rahulahooper/watering-system/pcb.JPG

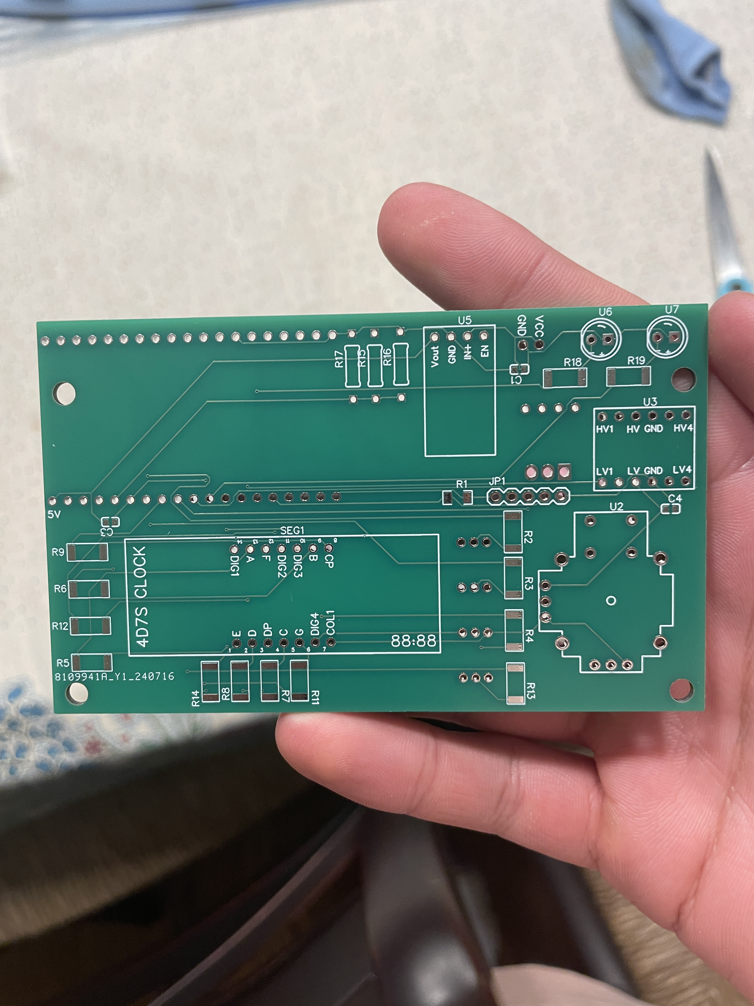
pcb.JPG
