rahulahooper/watering-system/main.jpg

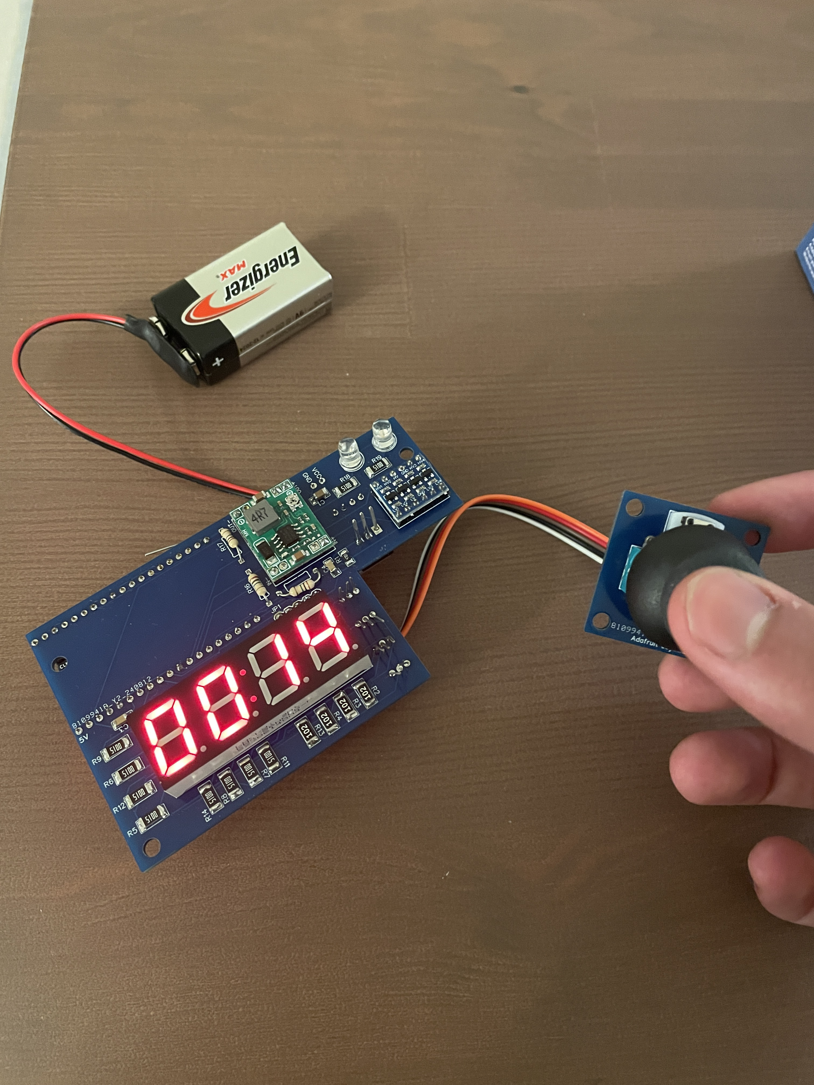
[picture p1: main.jpg]
main.jpg
